supermileage/FCP_Safety_Board/FCP_Safety_Board/MCAD/Safety_Housing_v1.SLDPRT

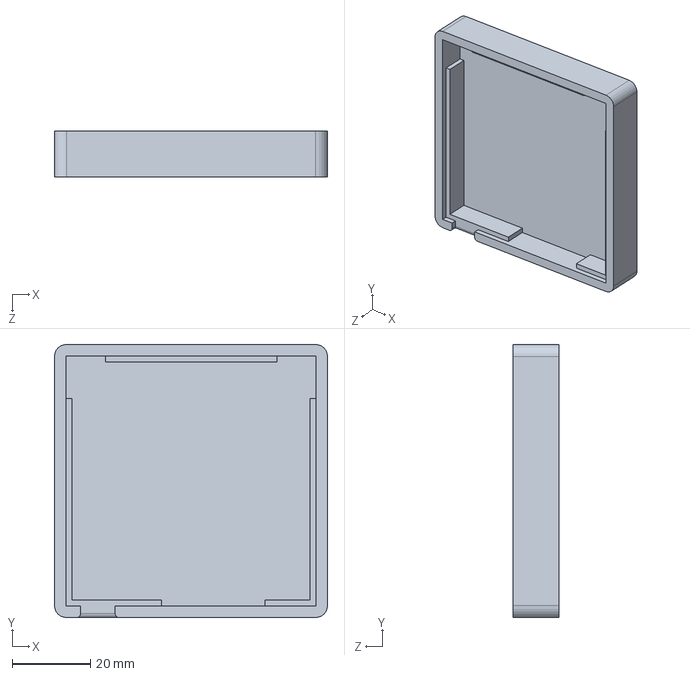
[picture p1: CAD file, 2022-03-27]
FCP_Safety_Board/MCAD/Safety_Housing_v1.SLDPRT
69.6 x 69.6 x 11.6 mm
