supermileage/FCP_Safety_Board/(list of files, cad)

Other CAD files:
FCP_Safety_Board/ECAD/Safety.DWG
FCP_Safety_Board/MCAD/Safety_Housing_v1.STL
