supermileage/FCP_Safety_Board/(list of files, drawings)

Other design files:
FCP_Safety_Board/ECAD/PCB_Project.PrjPcb
FCP_Safety_Board/ECAD/PCB_Project.SCHLIB
FCP_Safety_Board/ECAD/Safety.PcbDoc
FCP_Safety_Board/ECAD/Safety.PcbLib
FCP_Safety_Board/ECAD/Sheet1.SchDoc
FCP_Safety_Board/ECAD/Sheet2.SchDoc
