supermileage/FCP_Safety_Board/drafts_from_2022-2023/SafetyPCB/SafetyPCB.kicad_pcb

## KiCad design drafts_from_2022-2023/SafetyPCB/SafetyPCB.kicad_pcb (2023-09-26)

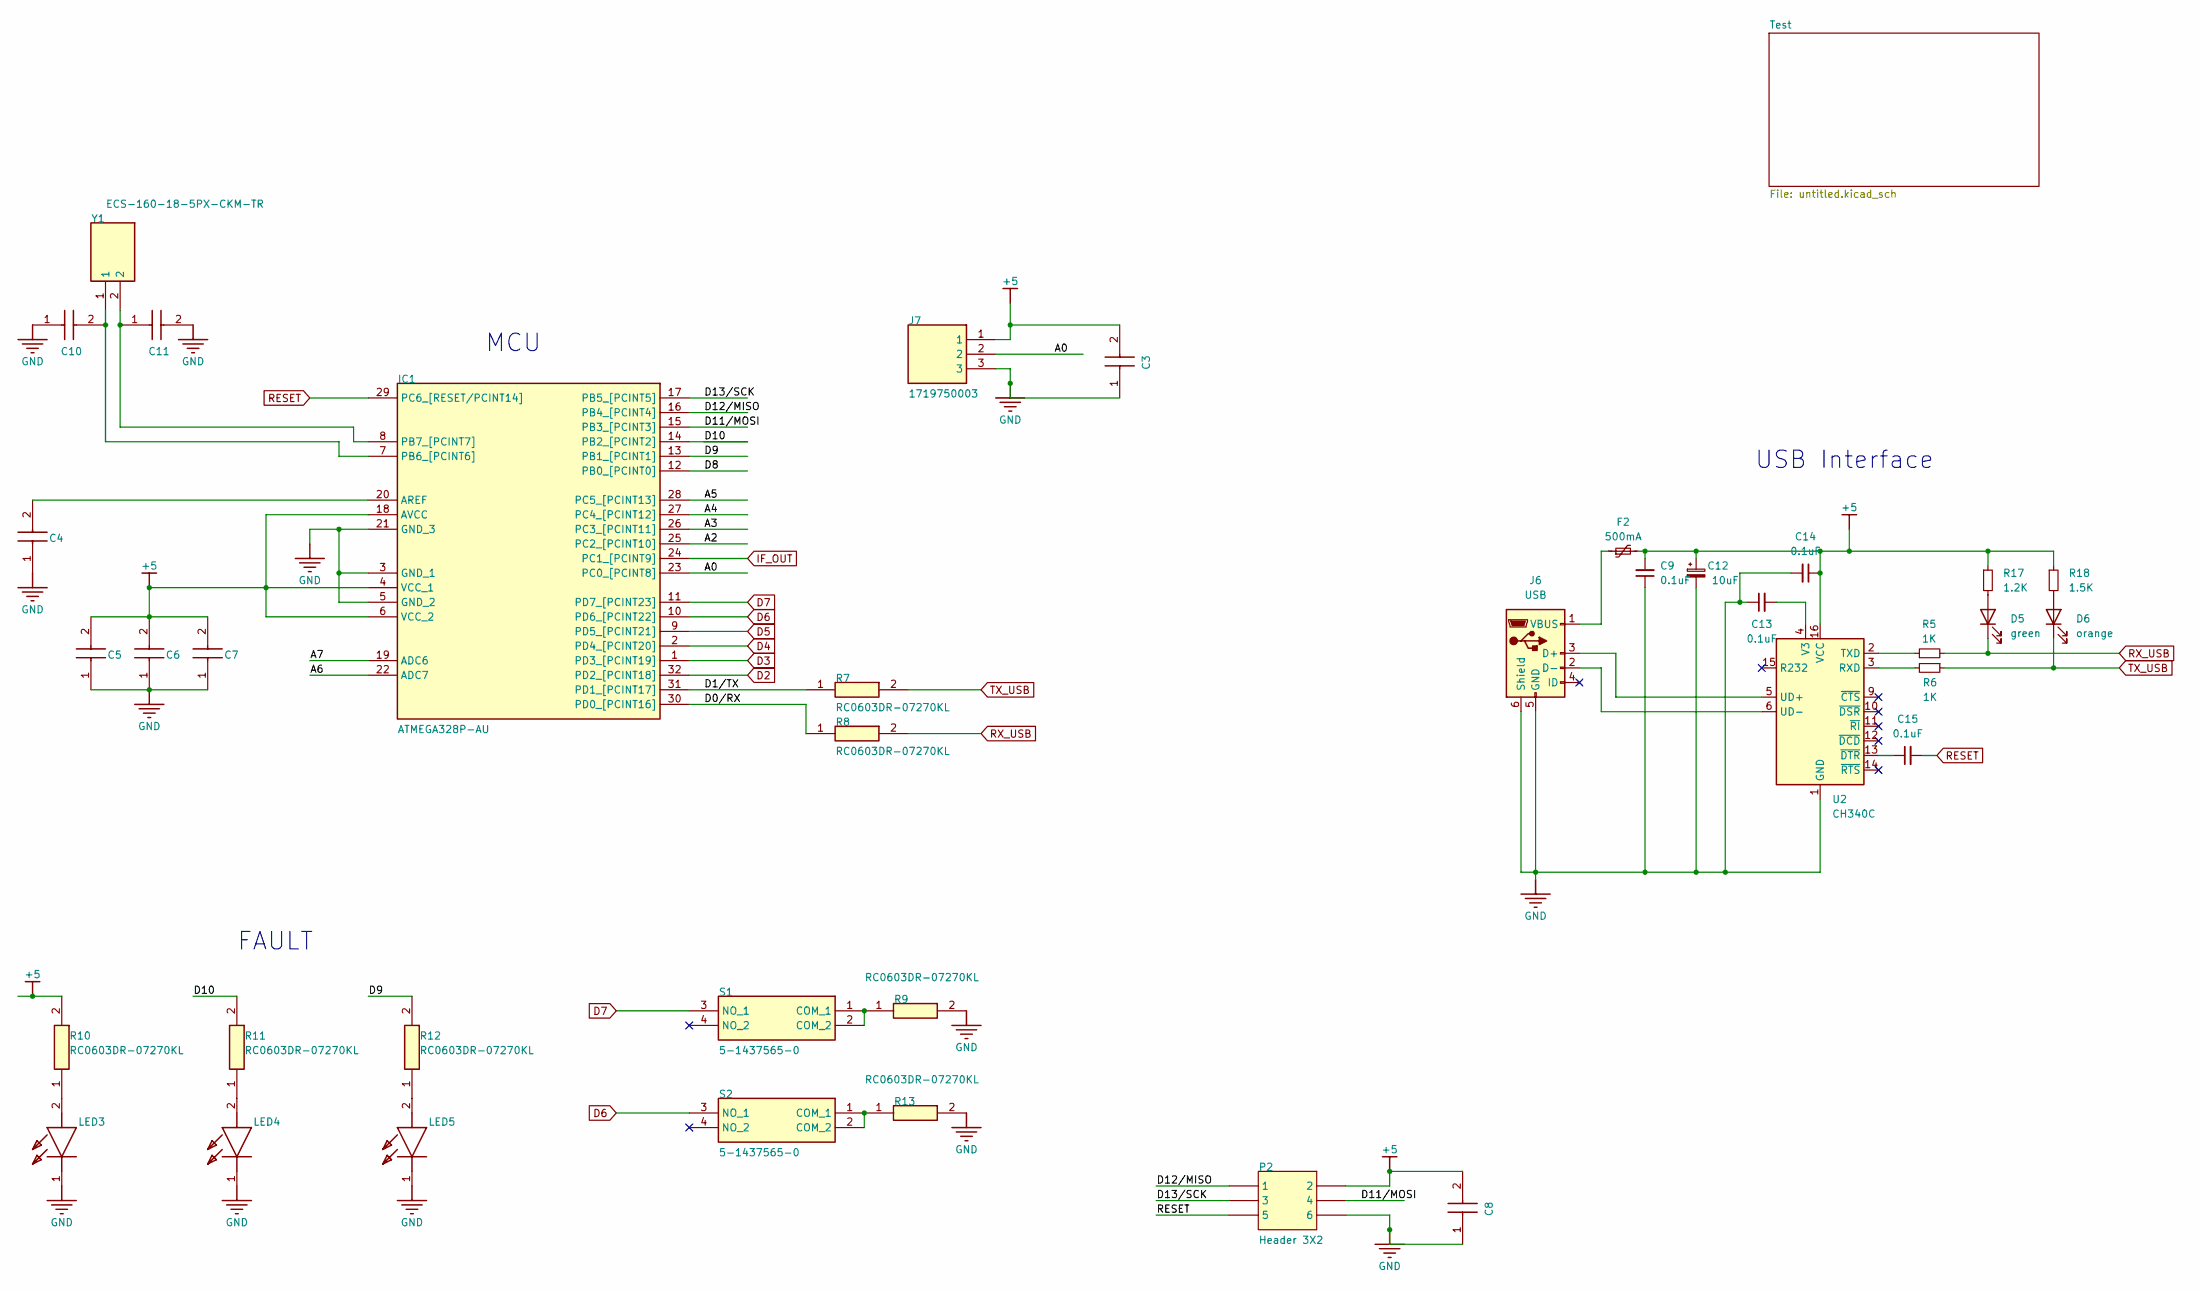
[picture p2: schematic SafetyPCB.kicad_sch]

Parts:
C3, C8, C11: 0.1uF; C_0603_1608Metric; MOUSER PART NUMBER 80-C0603C104K3R; digikey part number 399-C0603C104K3RAC7867TR-ND
C4, C5, C6, C7, C10: 0.1uF; C_0603_1608Metric; MOUSER PART NUMBER 80-C0603C104K3R; digikey part number C0603C104K3RACTU
C9, C13, C14, C15: 0.1uF; C_0603_1608Metric
C12: 10uF; C_1206_3216Metric
D5: green; LED_0805_2012Metric
D6: orange; LED_0805_2012Metric
F2: 500mA; Fuse_1206_3216Metric
IC1: ATMEGA328P-AU; QFP80P900X900X120-32N; MANUFACTURER_PART_NUMBER ATMEGA328P-AU; MOUSER PART NUMBER 556-ATMEGA328P-AU
J6: USB; USB_Micro-B_Molex_47346-0001
J7: 1719750003; MOLEX_1719750003; digikey part number 1719750003
LED3, LED4, LED5: LTST-C191TBKT-5A; LED_0201_0603Metric; MOUSER PART NUMBER 859-LTST-C191TBKT-5A; digikey part number LTST-C191TBKT-5A
P2: Header 3X2; PinHeader_2x03_P2.54mm_Vertical
R5, R6: 1K; R_0805_2012Metric
R7, R8, R9, R13: RC0603DR-07270KL; R_0603_1608Metric; digikey part number RC0603DR-07270KL
R10: RC0603DR-07270KL; R_0603_1608Metric; MOUSER PART NUMBER RC0603DR-07270KL-ND - Tape & Reel (TR); digikey part number RC0603DR-07270KL-ND
R11: RC0603DR-07270KL; R_0603_1608Metric; digikey part number RC0603DR-07270KL-ND
R12: RC0603DR-07270KL; R_0603_1608Metric; MANUFACTURER_PART_NUMBER RC0603DR-07270KL; digikey part number RC0603DR-07270KL-ND
R17: 1.2K; R_0805_2012Metric
R18: 1.5K; R_0805_2012Metric
S1, S2: 5-1437565-0; SW_5-1437565-0; MANUFACTURER_PART_NUMBER 5-1437565-0; MOUSER PART NUMBER 506-5-1437565-0
U2: CH340C; SOIC-16_3.9x9.9mm_P1.27mm
Y1: ECS-160-18-5PX-CKM-TR; XTAL_ECS-160-18-5PX-CKM-TR; MANUFACTURER_PART_NUMBER ECS-160-18-5PX-CKM-TR; digikey part number 50-ECS-160-18-5PX-CKM-TR-ND

Connections:
+5: C3.2, C5.2, C6.2, C7.2, C8.2, C9.2, C12.1, C14.1, F2.2, IC1.4 (VCC_1), IC1.6 (VCC_2), IC1.18 (AVCC), J7.1, P2.2, R10.2, R17.1, R18.1, U2.16 (VCC); also elsewhere on the board
/A0: IC1.23 (PC0_[PCINT8]), J7.2
/A2: IC1.25 (PC2_[PCINT10])
/A3: IC1.26 (PC3_[PCINT11])
/A4: IC1.27 (PC4_[PCINT12])
/A5: IC1.28 (PC5_[PCINT13])
/A6: IC1.22 (ADC7)
/A7: IC1.19 (ADC6)
/D0/RX: IC1.30 (PD0_[PCINT16]), R8.1
/D1/TX: IC1.31 (PD1_[PCINT17]), R7.1
/D8: IC1.12 (PB0_[PCINT0])
/D9: IC1.13 (PB1_[PCINT1]), R12.2
/D10: IC1.14 (PB2_[PCINT2]), R11.2
/D11/MOSI: IC1.15 (PB3_[PCINT3]), P2.4
/D12/MISO: IC1.16 (PB4_[PCINT4]), P2.1
/D13/SCK: IC1.17 (PB5_[PCINT5]), P2.3
D2: IC1.32 (PD2_[PCINT18]); also elsewhere on the board
D3: IC1.1 (PD3_[PCINT19]); also elsewhere on the board
D4: IC1.2 (PD4_[PCINT20]); also elsewhere on the board
D5: IC1.9 (PD5_[PCINT21]); also elsewhere on the board
D6: IC1.10 (PD6_[PCINT22]), S2.3 (NO_1)
D7: IC1.11 (PD7_[PCINT23]), S1.3 (NO_1)
GND: C3.1, C4.1, C5.1, C6.1, C7.1, C8.1, C9.1, C10.1, C11.2, C12.2, C13.1, C14.2, IC1.3 (GND_1), IC1.5 (GND_2), IC1.21 (GND_3), J6.5 (GND), J6.6 (Shield), J7.3, LED3.1 (K), LED4.1 (K), LED5.1 (K), P2.6, R9.2, R13.2, U2.1 (GND); also elsewhere on the board
IF_OUT: IC1.24 (PC1_[PCINT9]); also elsewhere on the board
unnamed: C4.2, IC1.20 (AREF)
unnamed: C10.2, IC1.7 (PB6_[PCINT6]), Y1.1
unnamed: C11.1, IC1.8 (PB7_[PCINT7]), Y1.2
unnamed: C13.2, U2.4 (V3)
unnamed: C15.1, U2.13 (~DTR)
unnamed: D5.2 (A), R17.2
unnamed: D6.2 (A), R18.2
unnamed: F2.1, J6.1 (VBUS)
unnamed: J6.2 (D-), U2.6 (UD-)
unnamed: J6.3 (D+), U2.5 (UD+)
unnamed: LED3.2 (A), R10.1
unnamed 45: LED4.2 (A), R11.1; also elsewhere on the board
unnamed 46: LED5.2 (A), R12.1; also elsewhere on the board
unnamed: R5.1, U2.2 (TXD)
unnamed: R6.2, U2.3 (RXD)
unnamed: R9.1, S1.1 (COM_1), S1.2 (COM_2)
unnamed: R13.1, S2.1 (COM_1), S2.2 (COM_2)
RESET: C15.2, IC1.29 (PC6_[RESET/PCINT14]), P2.5
RX_USB: D5.1 (K), R5.2, R8.2
TX_USB: D6.1 (K), R6.1, R7.2

Notes on the sheet:
USB Interface
FAULT
MCU

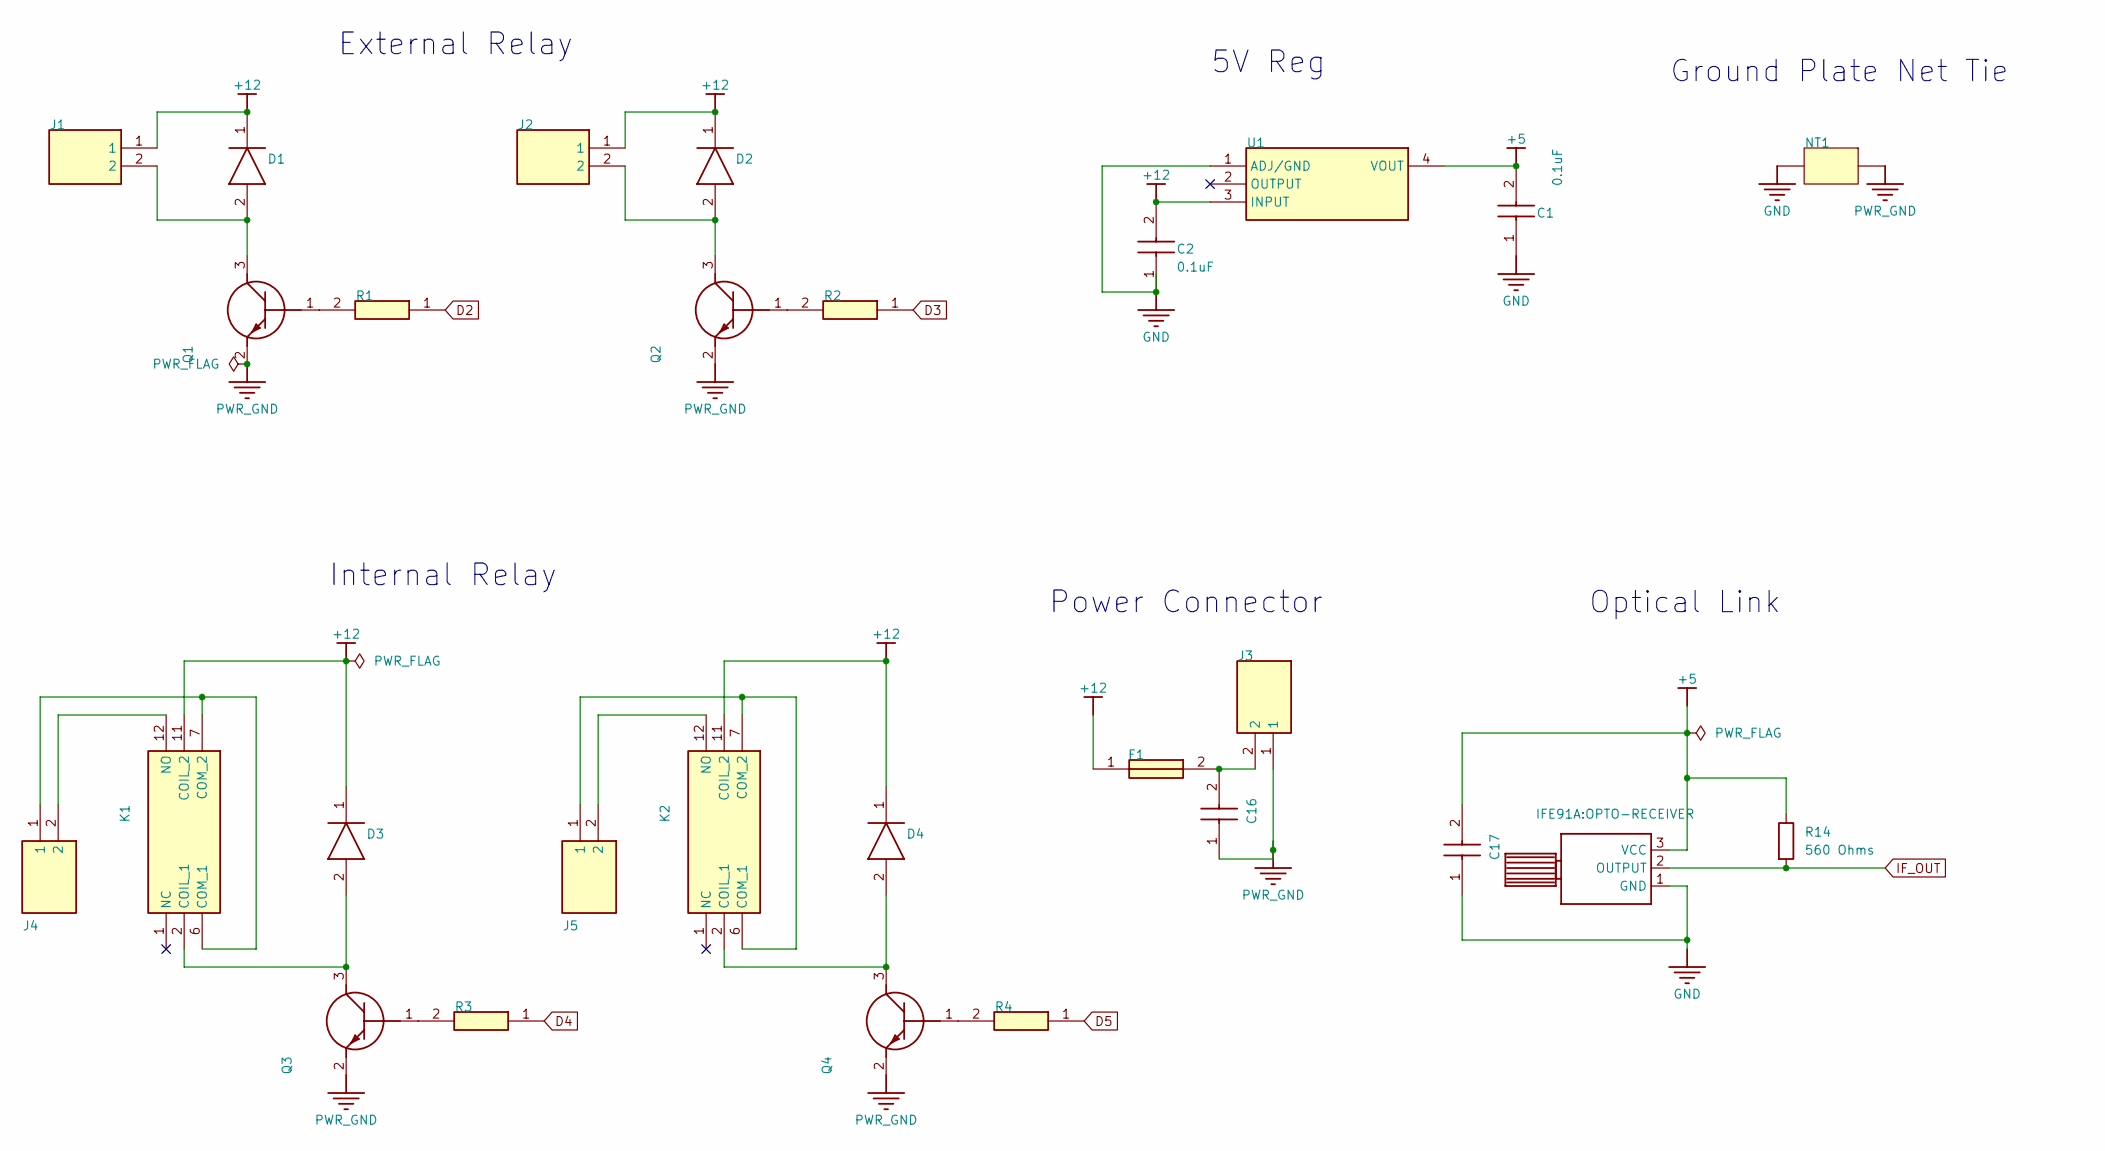
[picture p3: schematic untitled.kicad_sch]

Parts:
C1, C2: 0.1uF; C_0603_1608Metric; MOUSER PART NUMBER 80-C0603C104K3R; digikey part number C0603C104K3RACTU
C16, C17: 0.1uF; C_0603_1608Metric; MOUSER PART NUMBER 80-C0603C104K3R; digikey part number 399-C0603C104K3RAC7867TR-ND
D1, D2, D3, D4: DIOM4325X250N_Safety; MOUSER PART NUMBER 512-S1A; digikey part number S1A
F1: FUSE_0154010.DRL; MOUSER PART NUMBER 530-0678H9100-02; digikey part number 0154010.DR
J1: MOLEX_1719750002; MOUSER PART NUMBER 538-171975-0002; digikey part number 171975-0002
J2, J4, J5: MOLEX_1719750002; MANUFACTURER_PART_NUMBER 171975-0002; MOUSER PART NUMBER 538-171975-0002
J3: Molex_Micro-Fit_3.0_43045-0200_2x01_P3.00mm_Horizontal; MANUFACTURER_PART_NUMBER 0430450200; MOUSER PART NUMBER N/A
K1, K2: 1422037-2; MANUFACTURER_PART_NUMBER 1422037-2; MOUSER PART NUMBER 655-1422037-2
NT1: NetTie
Q1, Q2, Q3, Q4: SOT95P237X111-3N; MANUFACTURER_PART_NUMBER BCW66GLT1G; MOUSER PART NUMBER 863-BCW66GLT1G
R1, R2, R3, R4: R_0603_1608Metric; MANUFACTURER_PART_NUMBER RC0603DR-07270KL
R14: 560 Ohms; R_0603_1608Metric
U1: SOT230P700X180-4N; MANUFACTURER_PART_NUMBER LM1117IMPX-5.0/NOPB; MOUSER PART NUMBER 926-LM1117IMPX50NOPB
U$1: IF-D96F; OPTO-RECEIVER

Connections:
+5: C1.2, C17.2, R14.1, U1.4 (VOUT), U$1.3 (VCC); also elsewhere on the board
+12: C2.2, D1.1 (K), D2.1 (K), D3.1 (K), D4.1 (K), F1.1, J1.1, J2.1, K1.11 (COIL_2), K2.11 (COIL_2), U1.3 (INPUT)
D2: R1.1; also elsewhere on the board
D3: R2.1; also elsewhere on the board
D4: R3.1; also elsewhere on the board
D5: R4.1; also elsewhere on the board
GND: C1.1, C2.1, C17.1, NT1.1, U1.1 (ADJ/GND), U$1.1 (GND); also elsewhere on the board
IF_OUT: R14.2, U$1.2 (OUTPUT); also elsewhere on the board
unnamed: C16.2, F1.2, J3.2
unnamed: D1.2 (A), J1.2, Q1.3 (C)
unnamed: D2.2 (A), J2.2, Q2.3 (C)
unnamed: D3.2 (A), K1.2 (COIL_1), Q3.3 (C)
unnamed: D4.2 (A), K2.2 (COIL_1), Q4.3 (C)
unnamed: J4.1, K1.6 (COM_1), K1.7 (COM_2)
unnamed: J4.2, K1.12 (NO)
unnamed: J5.1, K2.6 (COM_1), K2.7 (COM_2)
unnamed: J5.2, K2.12 (NO)
unnamed: Q1.1 (B), R1.2
unnamed: Q2.1 (B), R2.2
unnamed: Q3.1 (B), R3.2
unnamed: Q4.1 (B), R4.2
PWR_GND: C16.1, J3.1, NT1.2, Q1.2 (E), Q2.2 (E), Q3.2 (E), Q4.2 (E)

Notes on the sheet:
Internal Relay
Power Connector
Optical Link
Ground Plate Net Tie
5V Reg
External Relay

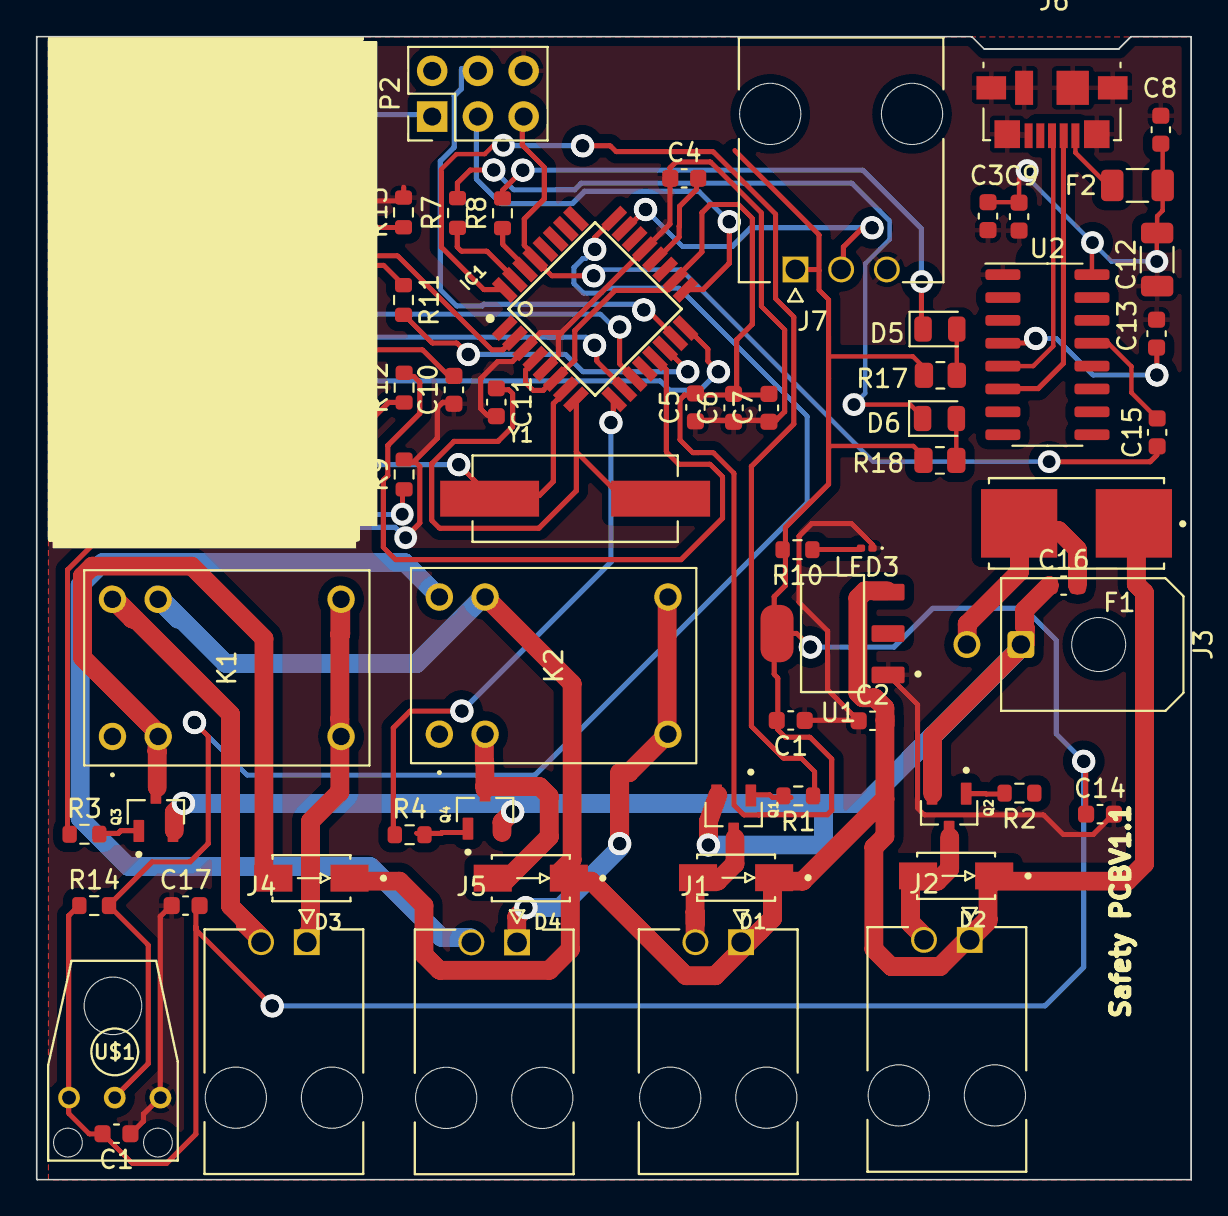
[picture p4: board SafetyPCB.kicad_pcb from above]

Board: 2 copper layers, 64.1 x 63.5 mm, 66 parts (0 on the bottom side), 50 nets.

Other parts of the board:
C1#2: 0.1uF; C_0603_1608Metric
LED4#2, LED5#2: LTST-C191TBKT-5A; LED_0201_0603Metric

Their connections:
+5: C1#2.2; also elsewhere on the board
GND: C1#2.1, LED4#2.1 (K), LED5#2.1 (K); also elsewhere on the board
unnamed 45: LED4#2.2 (A); also elsewhere on the board
unnamed 46: LED5#2.2 (A); also elsewhere on the board
