supermileage/FCP_Safety_Board/(commit log)

2022-03-27 update with hydrogen sensor
2023-09-26 Most recent draft I could find - March 2023
    [Attempt2.kicad_pcb, BabySheet.kicad_sch, LordSaveMe.kicad_pcb, LordSaveMe.kicad_sch, MotherSheet.kicad_sch, NewSafetyPCB.kicad_pcb, NewSafetyPCB.kicad_sch, SafetyPCB.csv]
